sagir567/FinalProject/skull/images/instrucations images/RL.png

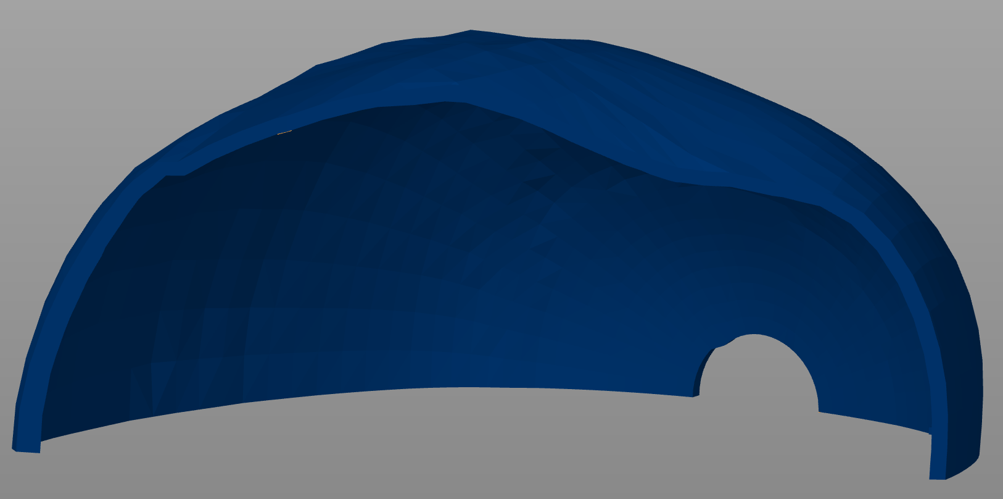
skull/images/instrucations images/RL.png
