sagir567/FinalProject/skull/images/instrucations images/S2.png

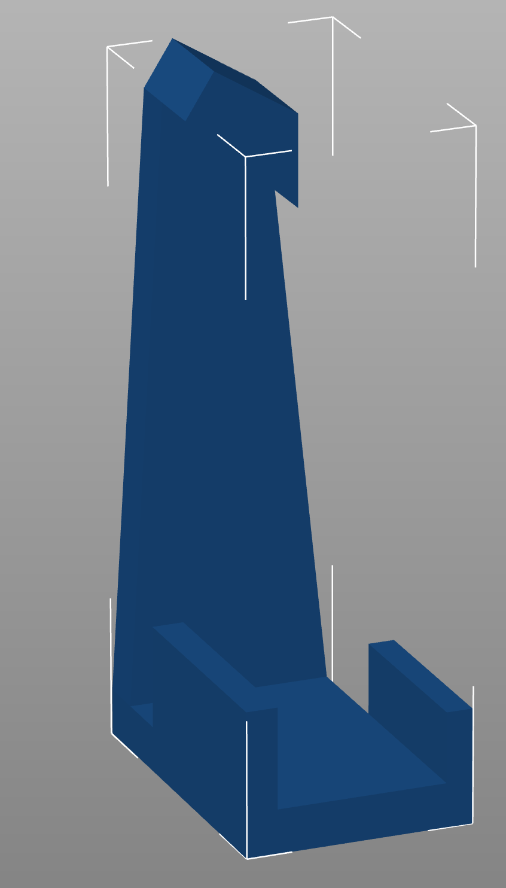
skull/images/instrucations images/S2.png
