sagir567/FinalProject/EMR models/EMR2/Screenshot 2024-11-19 at 12.36.32.png

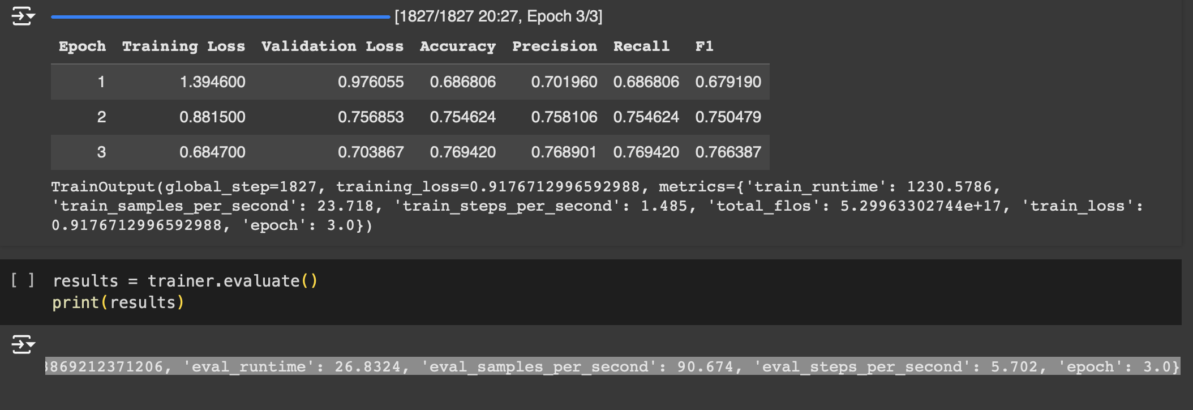
EMR models/EMR2/Screenshot 2024-11-19 at 12.36.32.png
