sagir567/FinalProject/EMR models/EMR3/Screenshot 2024-11-20 at 20.31.09.png

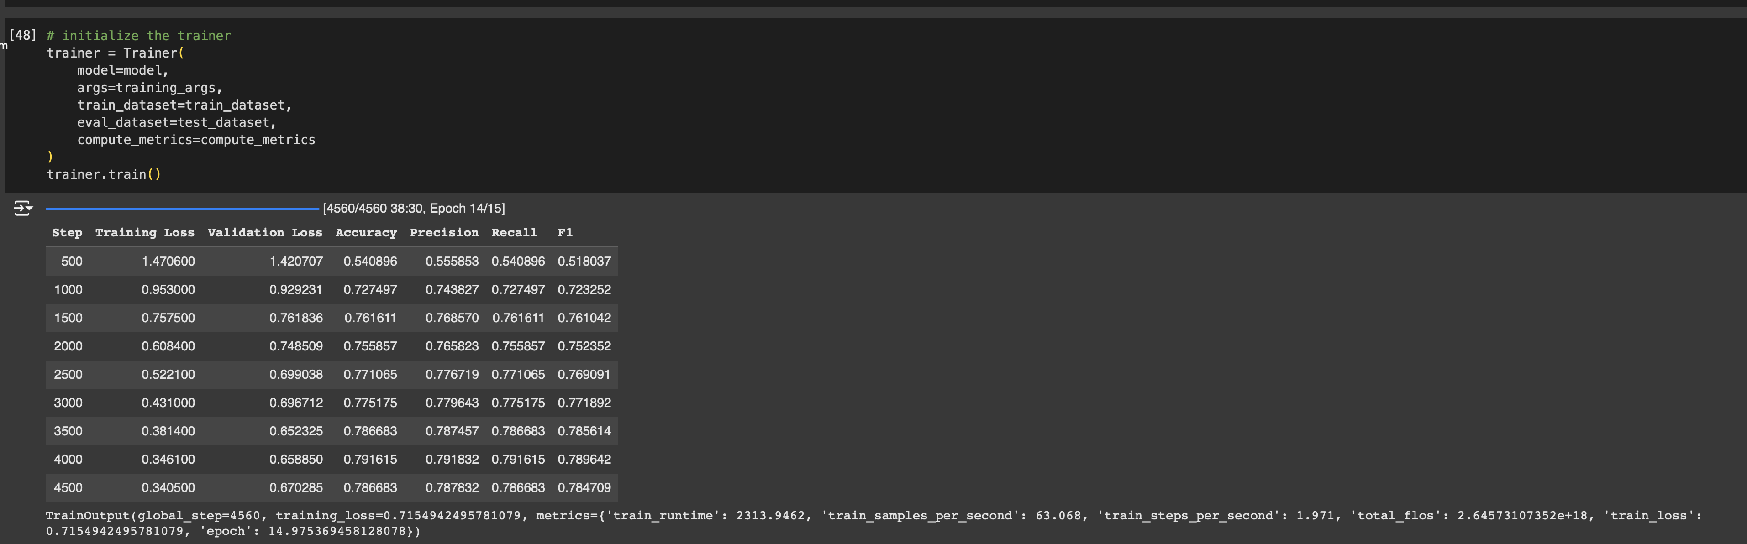
EMR models/EMR3/Screenshot 2024-11-20 at 20.31.09.png
