sagir567/FinalProject/EMR models/EMR4/Screenshot 2024-11-20 at 12.07.46.png

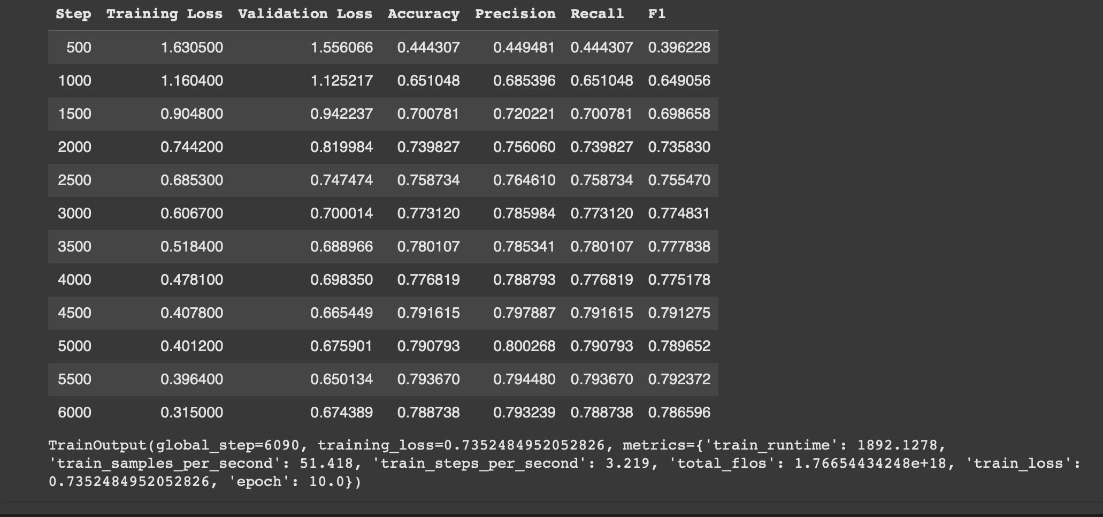
EMR models/EMR4/Screenshot 2024-11-20 at 12.07.46.png
