sagir567/FinalProject/EMR models/EMR4/Screenshot 2024-12-08 at 19.40.34.png

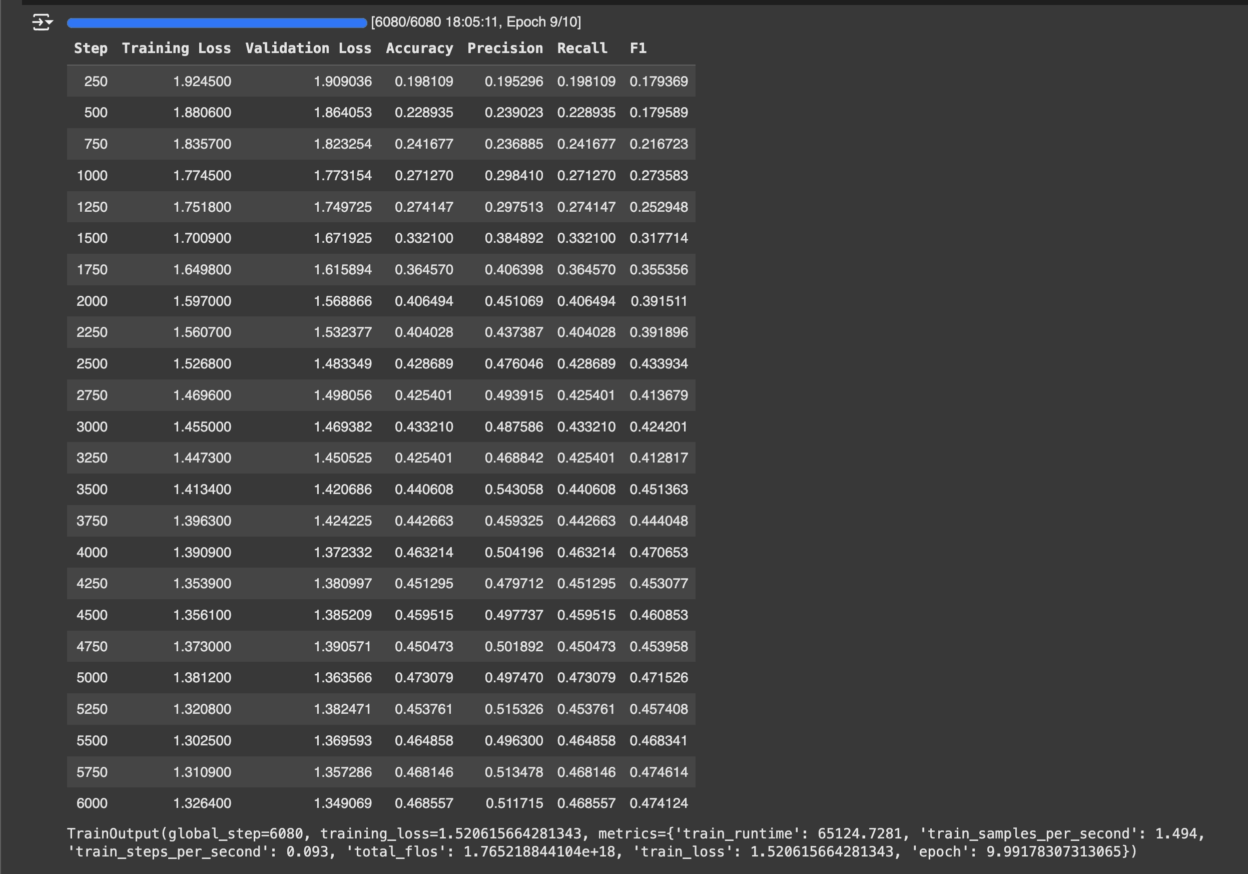
EMR models/EMR4/Screenshot 2024-12-08 at 19.40.34.png
