sagir567/FinalProject/skull/images/4bb4a7c94eef952b9f522b6513d4b394.jpg

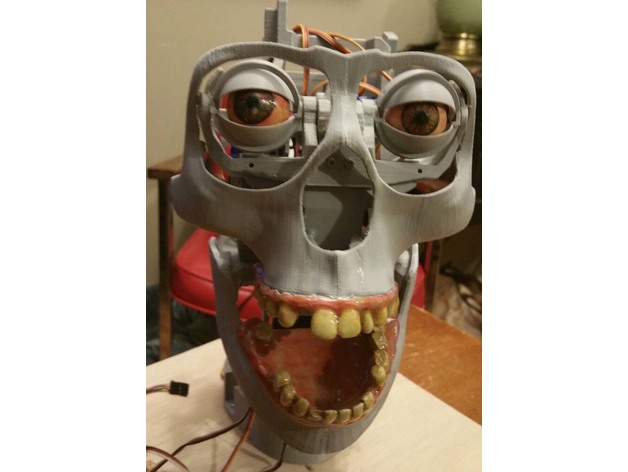
skull/images/4bb4a7c94eef952b9f522b6513d4b394.jpg
