sagir567/FinalProject/skull/images/53bd0c08fc8af762f6f15327d2c29858.jpg

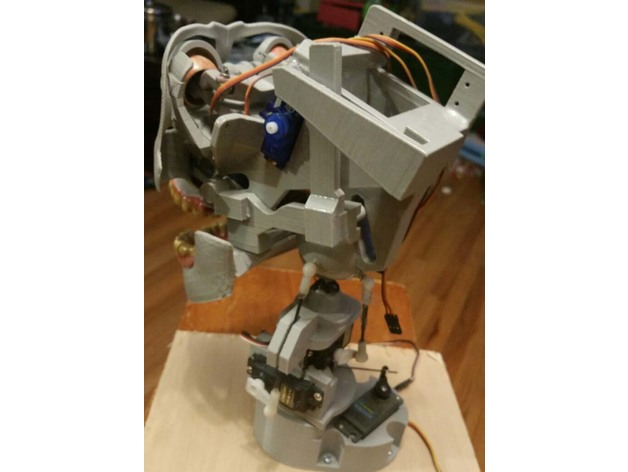
skull/images/53bd0c08fc8af762f6f15327d2c29858.jpg
