sagir567/FinalProject/skull/images/a4908c19597aabf069e994ebf08a3645_display_large.jpg

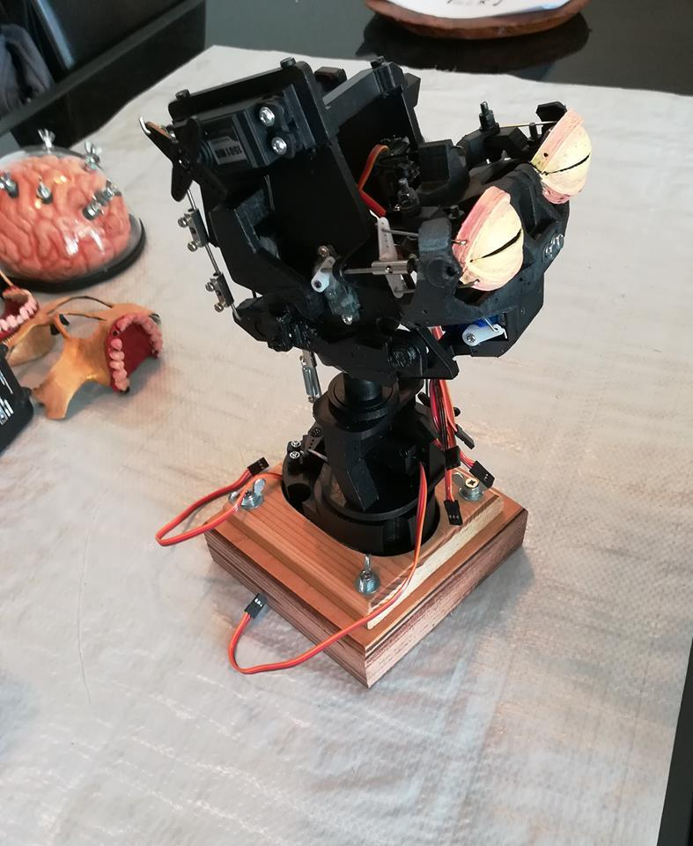
skull/images/a4908c19597aabf069e994ebf08a3645_display_large.jpg
