sagir567/FinalProject/skull/images/base.jpg

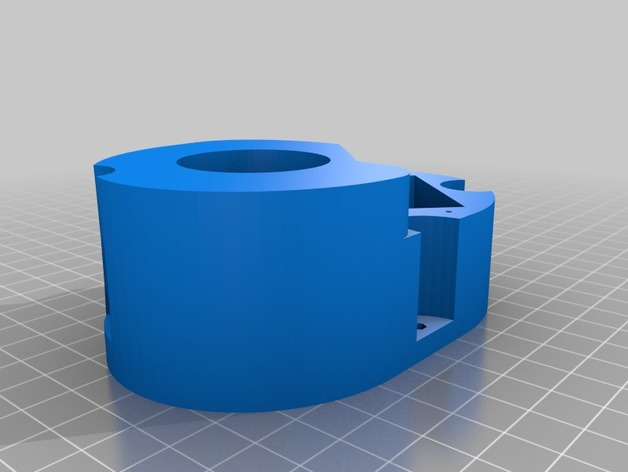
skull/images/base.jpg
