sagir567/FinalProject/skull/images/ccf05b85ca4c89a036585184b309f977.jpg

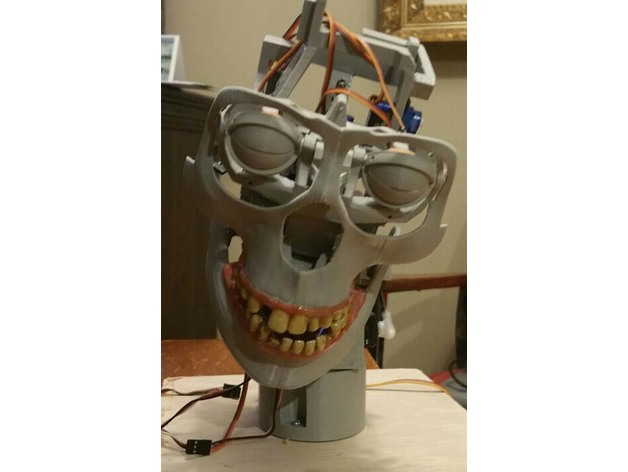
skull/images/ccf05b85ca4c89a036585184b309f977.jpg
