sagir567/FinalProject/skull/images/eyeballs.jpg

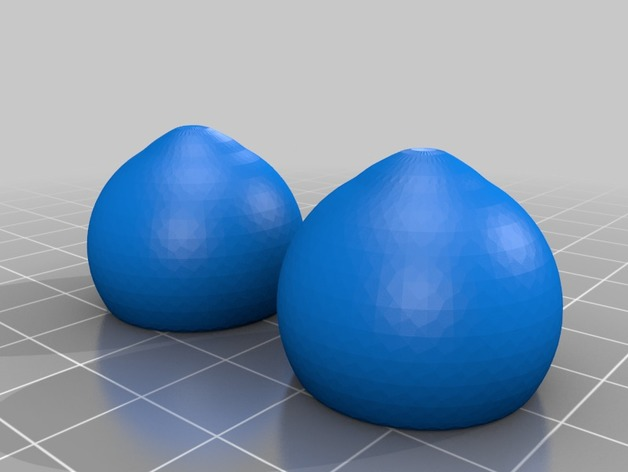
skull/images/eyeballs.jpg
