sagir567/FinalProject/skull/images/eyemech.jpg

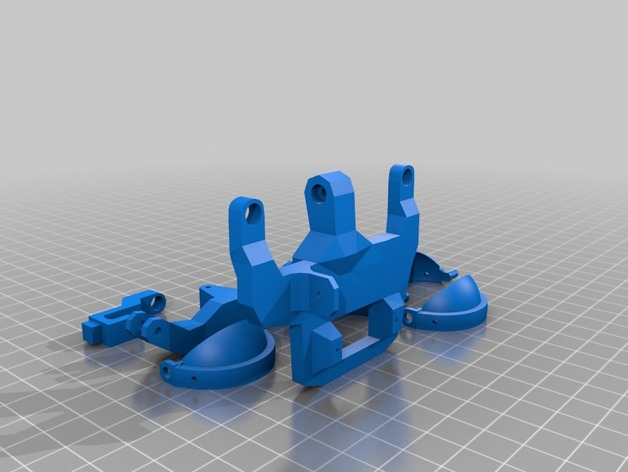
skull/images/eyemech.jpg
