sagir567/FinalProject/skull/images/f3ae5606e1d31408d69cdfd86e3f6843.jpg

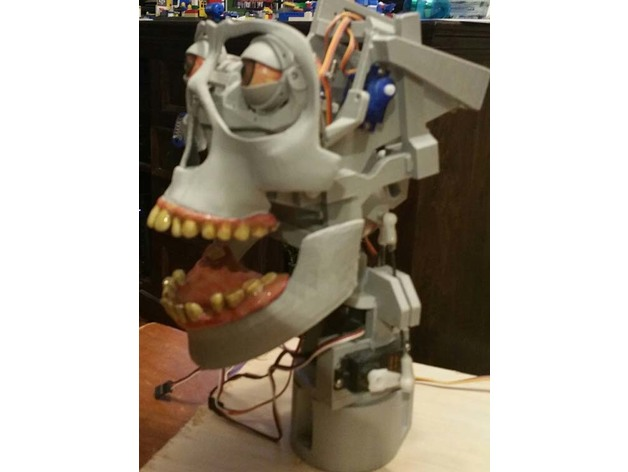
skull/images/f3ae5606e1d31408d69cdfd86e3f6843.jpg
