sagir567/FinalProject/skull/images/face.jpg

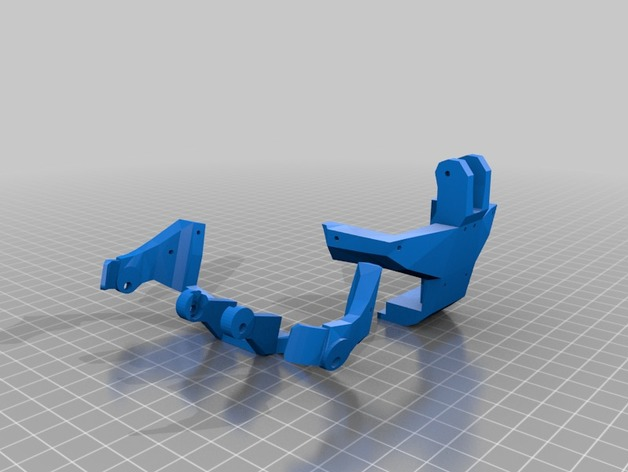
skull/images/face.jpg
