sagir567/FinalProject/skull/images/FullSkull.jpg

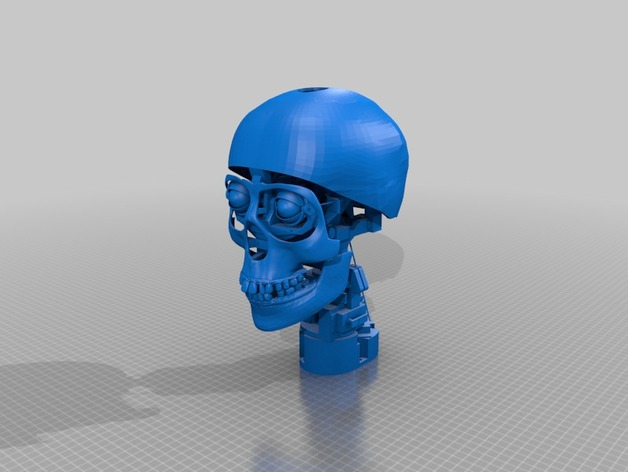
skull/images/FullSkull.jpg
