sagir567/FinalProject/skull/images/J8.png

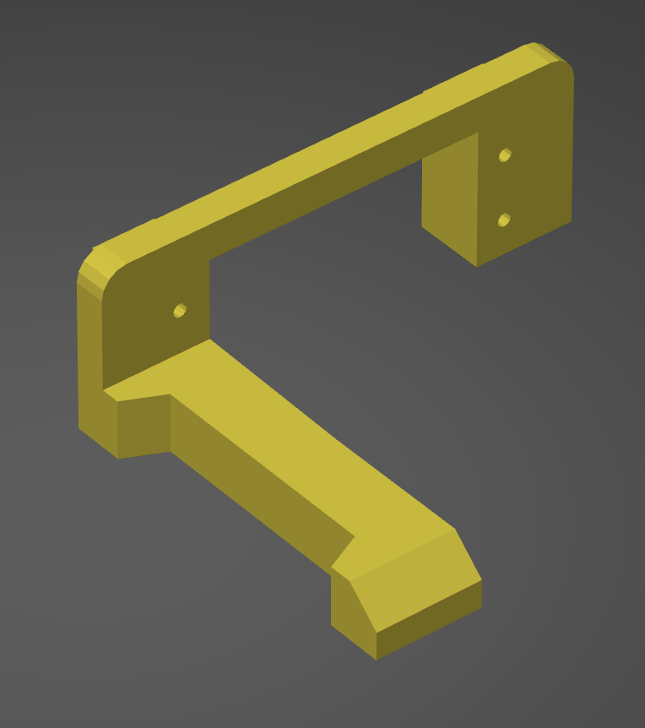
skull/images/J8.png
