sagir567/FinalProject/skull/images/jaw.jpg

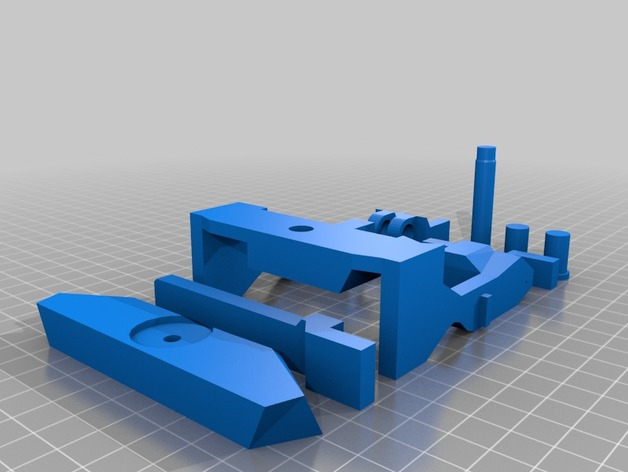
skull/images/jaw.jpg
