sagir567/FinalProject/skull/images/LeftSkull.jpg

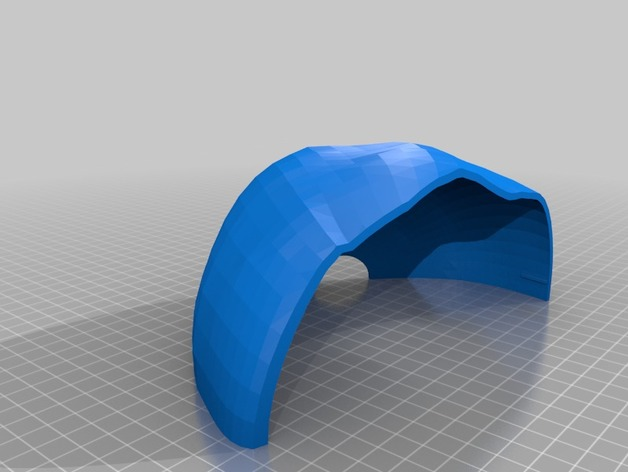
skull/images/LeftSkull.jpg
