sagir567/FinalProject/skull/images/Main.jpg

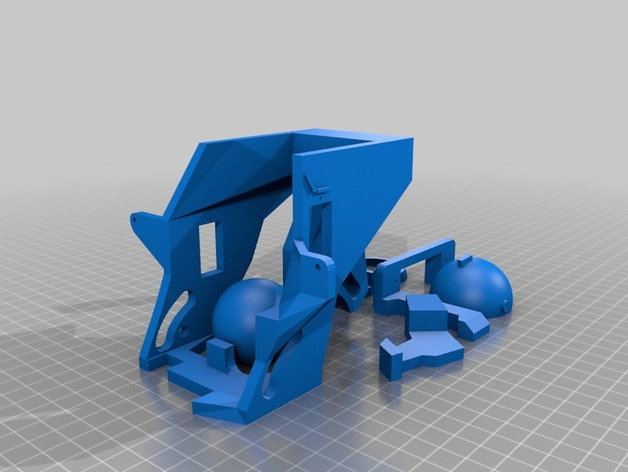
skull/images/Main.jpg
