sagir567/FinalProject/skull/images/Neck.jpg

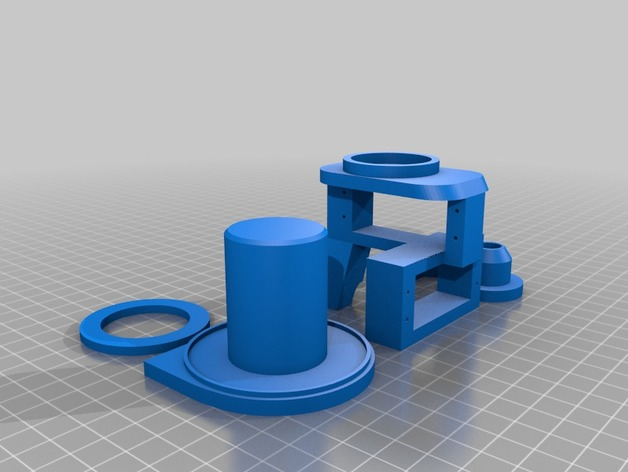
skull/images/Neck.jpg
