sagir567/FinalProject/skull/images/RightSkull.jpg

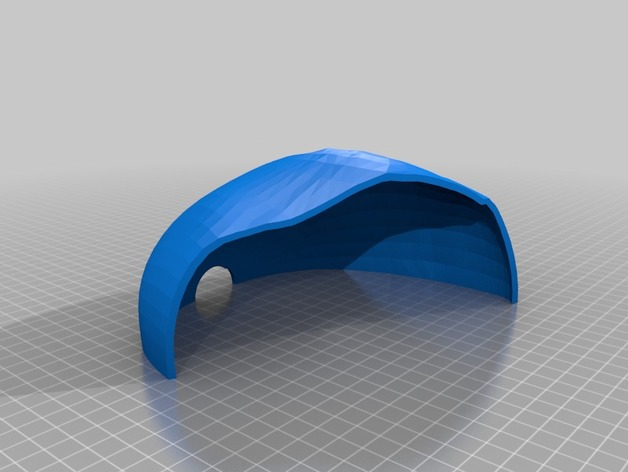
skull/images/RightSkull.jpg
