sagir567/FinalProject/skull/images/skullcapMounts.jpg

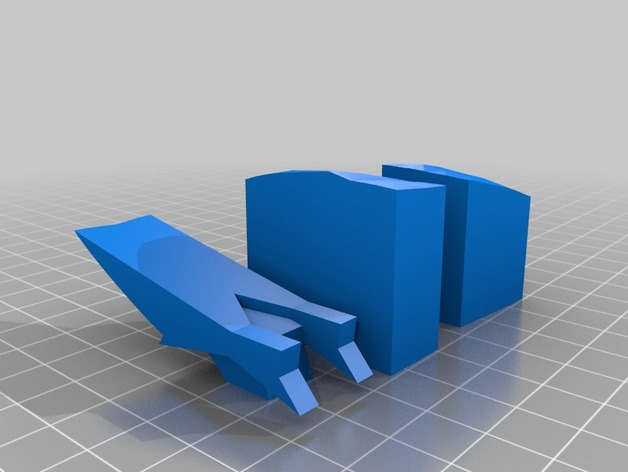
skull/images/skullcapMounts.jpg
