sagir567/FinalProject/skull/images/skullparts.jpg

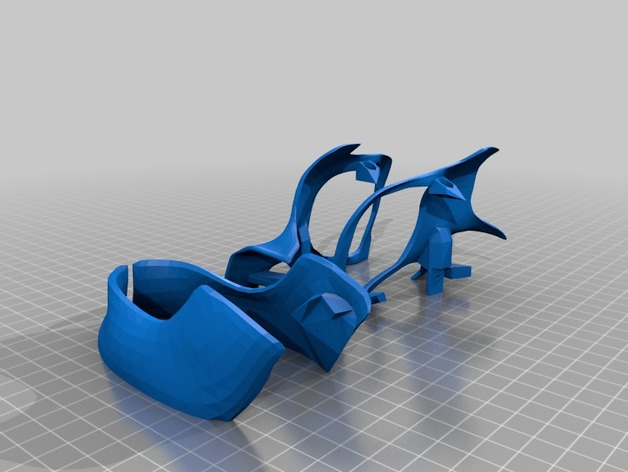
skull/images/skullparts.jpg
