sagir567/FinalProject/skull/images/teeth.jpg

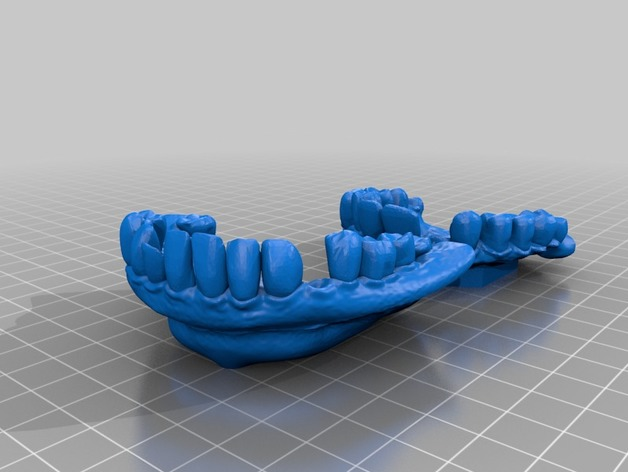
skull/images/teeth.jpg
