sagir567/FinalProject/סכימת פרוייקט.png

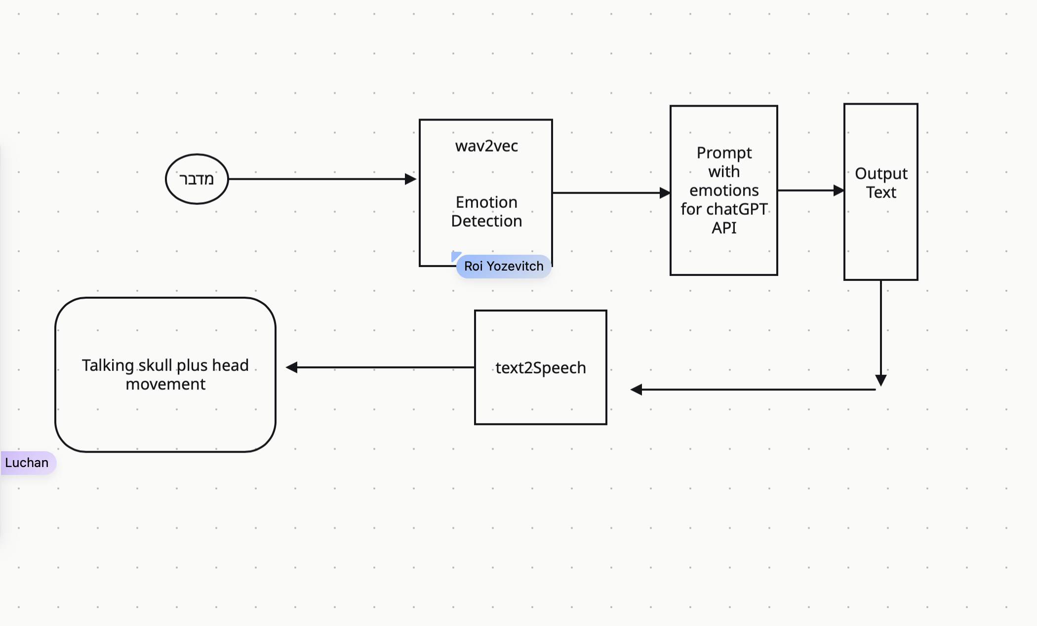
סכימת פרוייקט.png
