sagir567/FinalProject/(list of files, cad)

Other CAD files:
skull/STL/MainBall.stl
skull/STL/FullSkull.stl
skull/STL/Main.stl
skull/STL/MainNoSkelaton.STL
skull/images/instrucations images/B1.stl
skull/STL/neckCup.stl
skull/STL/TopEnclosure.STL
skull/STL/Neck.stl
skull/STL/teeth.stl
skull/STL/eyemech.stl
skull/STL/skullcapMounts.stl
skull/STL/skullparts.stl
skull/STL/eyeballs.stl
skull/STL/RightSkull.stl
skull/STL/jaw.stl
skull/STL/LeftSkull.stl
skull/STL/base.stl
skull/STL/face.stl
skull/STL/Skelaton.STL
skull/STL/microServoWeel.stl
