sagir567/FinalProject/wav2vec2Transformers/Animatronic skull build instructions.docx

Animatronic skull build instructions

Parts:

The projects contains the following parts.

We recommend printing all parts in Brim, 100% scale, 20-30% infill and with Petg(PlA is also an option but you should use higher infill), keep in mind that you don’t want the parts the be too heavy since you’ll need stronger servos.

1*B1: 1*N1: 1*N2:

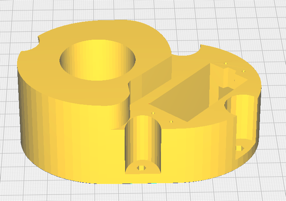
[picture p27: figure]
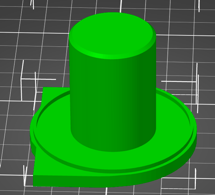
[picture p28: figure]
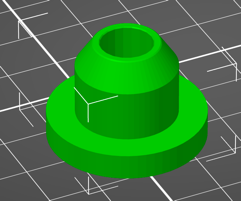
[picture p29: figure]

1*N3: 1*N4: 1*N5:

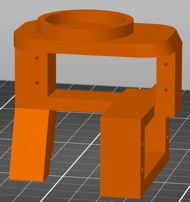
[picture p30: figure]
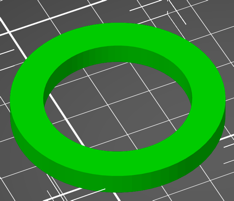
[picture p31: figure]
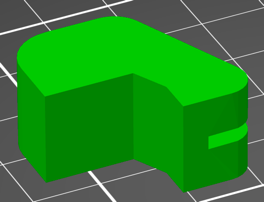
[picture p32: figure]

1*F1: 1*F2: 1*F3:

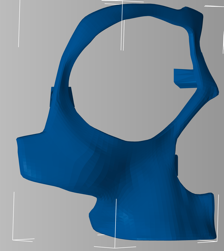
[picture p33: figure]
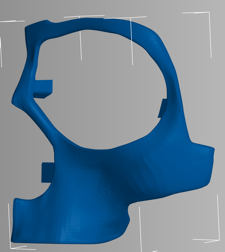
[picture p34: figure]
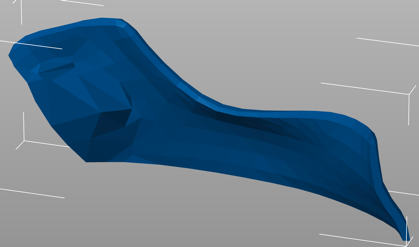
[picture p35: figure]

1*F4: 1*J1:

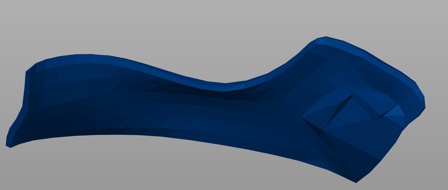
[picture p36: figure]
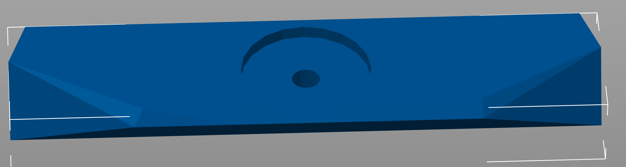
[picture p37: figure]

1*J2: 1*J3:

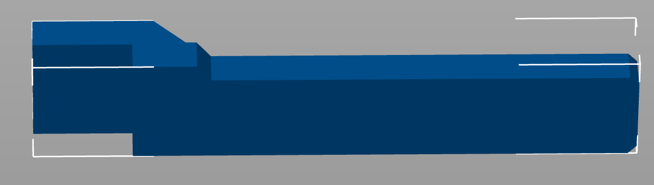
[picture p38: figure]
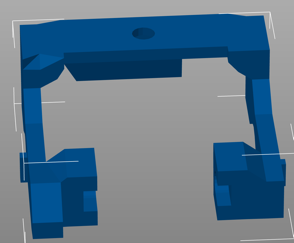
[picture p39: figure]

1*J4: 2*J5: 2*J6:

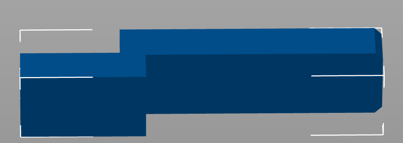
[picture p40: figure]
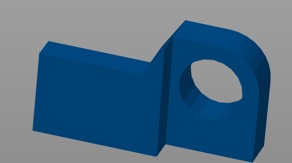
[picture p41: figure]

1*J7: M1: 1*M2:

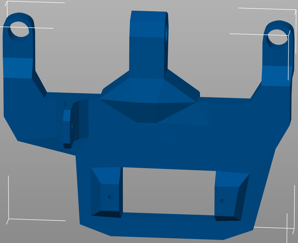
[picture p42: figure]
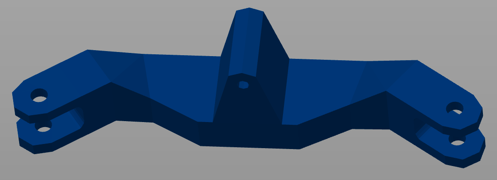
[picture p43: figure]

1*M3: 2*M4:

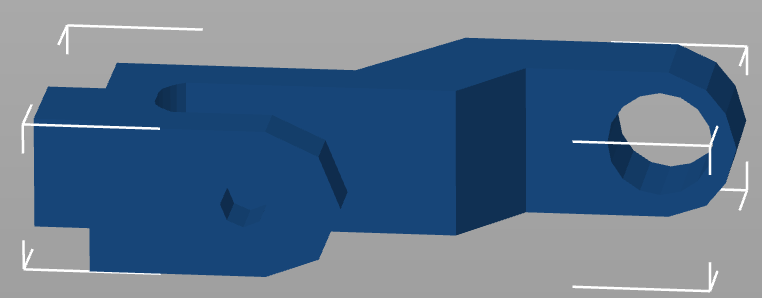
[picture p44: figure]
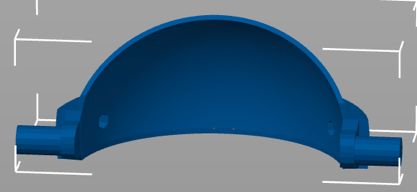
[picture p45: figure]

2*M5: 1*S1: 1*S2:

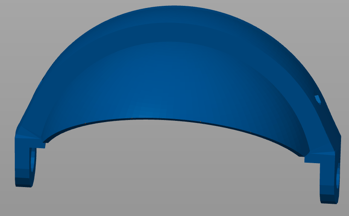
[picture p46: figure]
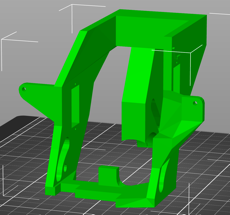
[picture p47: figure]
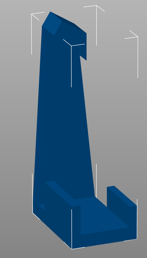
[picture p48: figure]

1*S3: 1*S4:

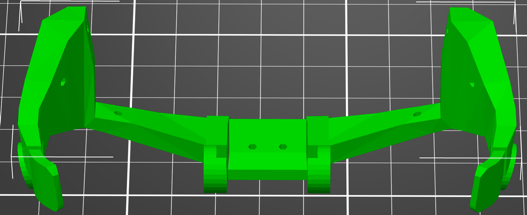
[picture p49: figure]
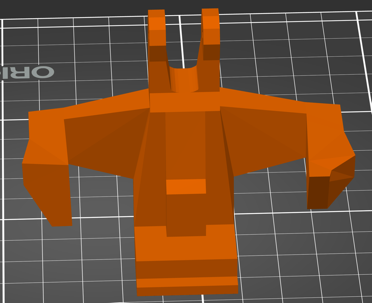
[picture p50: figure]

1*T1: 1*T2:

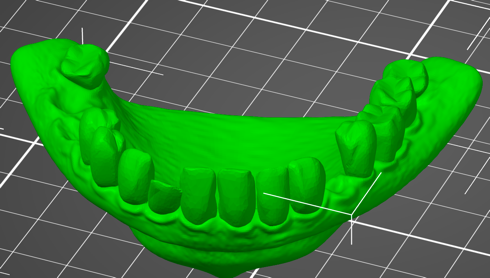
[picture p51: figure]
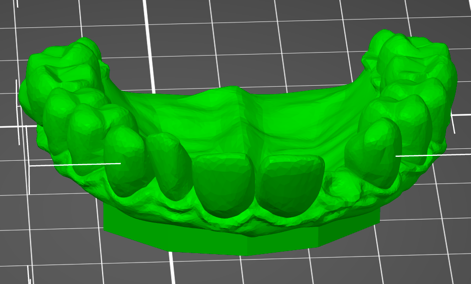
[picture p52: figure]

2*E: 1*RC: 1*RL:

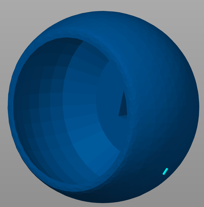
[picture p53: figure]
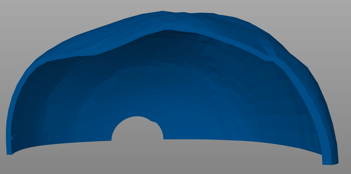
[picture p54: figure]
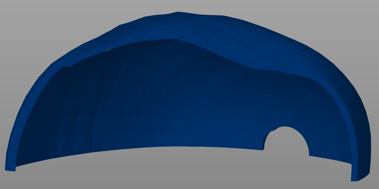
[picture p55: figure]

Tutorial:

1) Connect the M2 to both M3 using two m3 screws connector ( you may use hot glue to position the screw connector inside the M2 so there will be minimum loose)

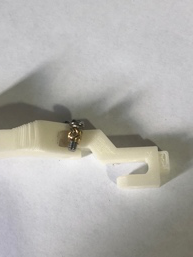
[picture p56: figure]
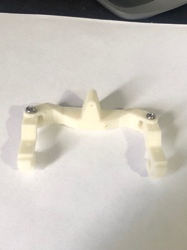
[picture p57: figure]
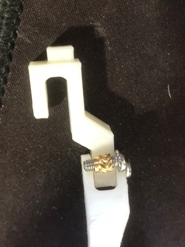
[picture p58: figure]

2) Connect M2 and M3 to the M1 using the same screw connector,
- the hook on the M1 supposed to be directed down.
- Use the same screw connector and two m3 screws

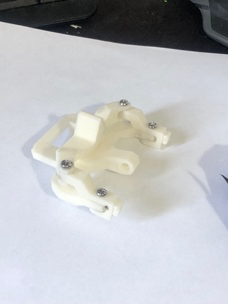
[picture p59: figure]
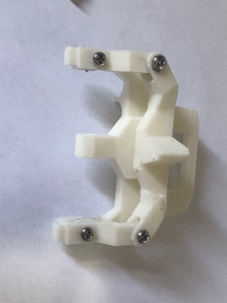
[picture p60: figure]
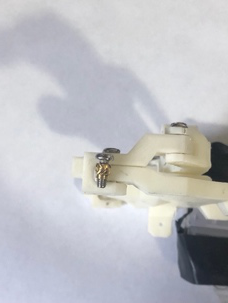
[picture p61: figure]

3) Using two m3 screws and 2 screws connectors connect M1 to S4, screws head should be in the outer side of S4

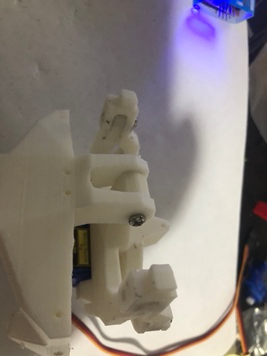
[picture p62: figure]
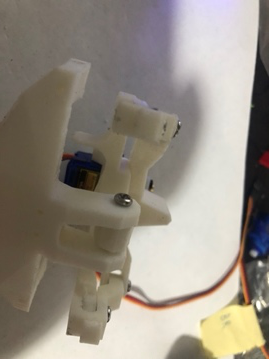
[picture p63: figure]
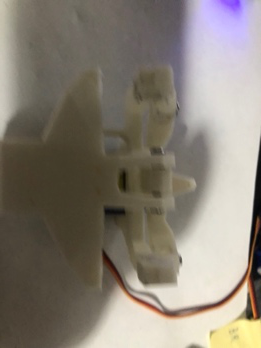
[picture p64: figure]

…………………….

4) Connect one mini servo to the M1, servo hand should be assemble from the left size, plug one pushed stoper to the servo and connect one hook to it , the hook should be inserted into the small hole in the M1 part

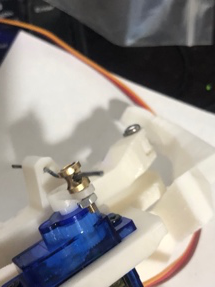
[picture p65: figure]
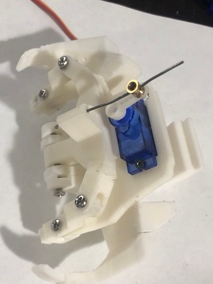
[picture p66: figure]
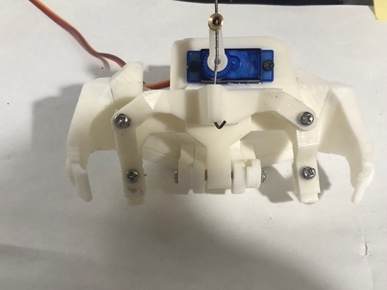
[picture p67: figure]
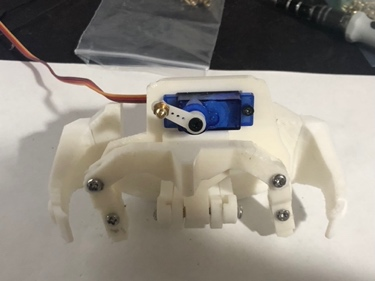
[picture p68: figure]

5) Take both J6 parts and glue them to the side of J3, after that plug both J5 parts to the H6 hole
- Flat part of J6 should be directed down.
- Before glue J6 parts make sure they move a bit loose in the S1 rials, if they don’t move loose, gently sand the S1 rails.

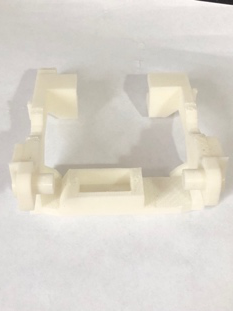
[picture p69: figure]
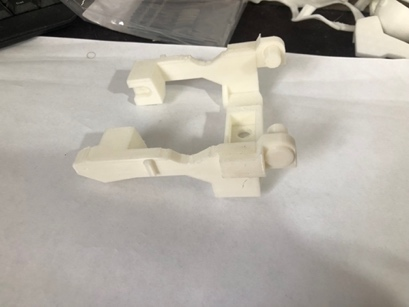
[picture p70: figure]
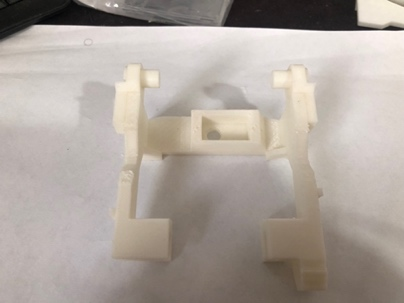
[picture p71: figure]

6) Screw one mini servo to the J3.
- The servo should be metal and a bit stronger because it need to lift and move the jaw part of the skull.

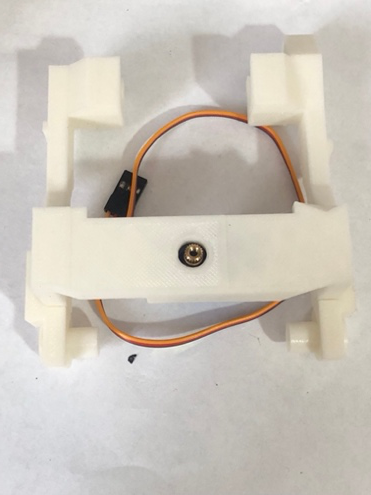
[picture p72: figure]
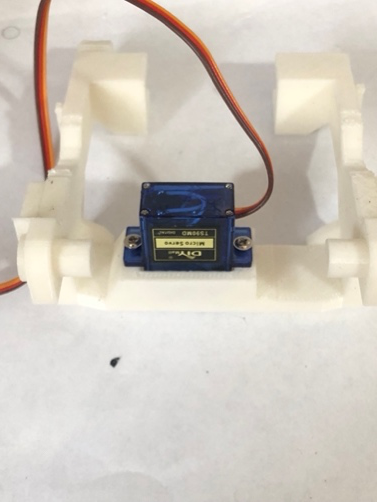
[picture p73: figure]
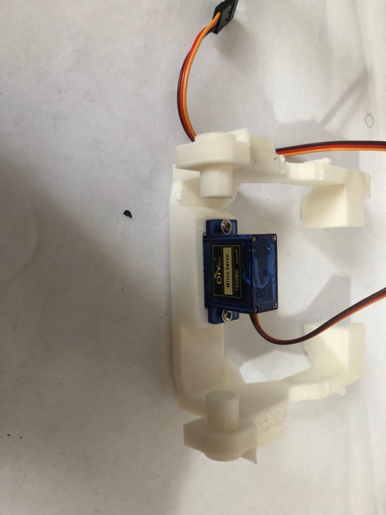
[picture p74: figure]

7) Take F3 and F4 and glue them together to T2
- Make sure you leave enough place between F3 and F4 to place J1

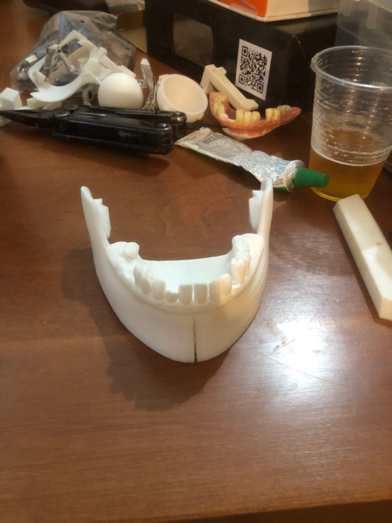
[picture p75: figure]
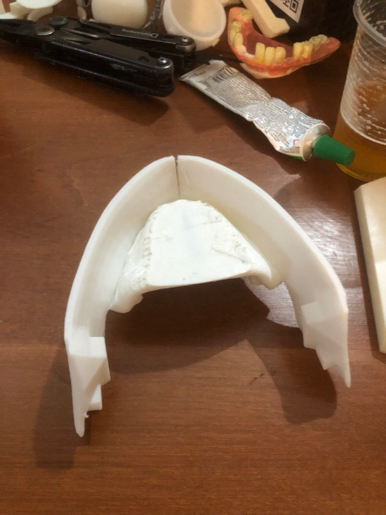
[picture p76: figure]

8) After the last part dry, connect glue J1 between F3 and F4,
- Servo wheel adapter should be position up direction, while its open side should be pointed opposite direction then the teeth

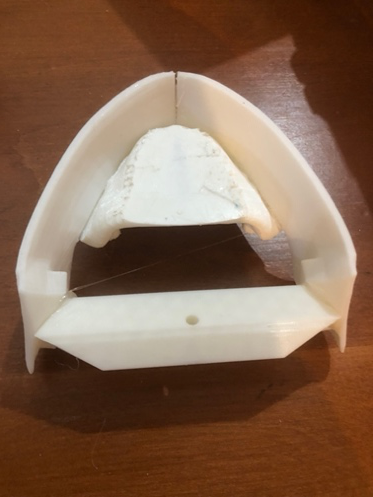
[picture p77: figure]
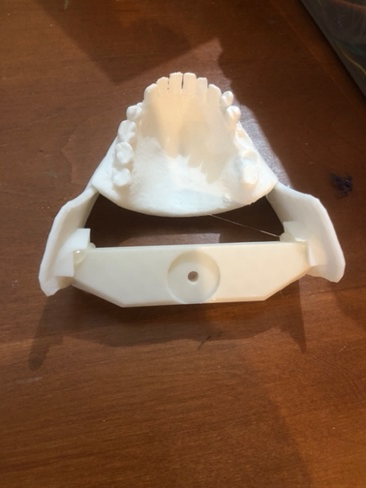
[picture p78: figure]

9) Use two m2 screws to connect F1 to the eye mech to build in the previous episodes, follow the same with F2

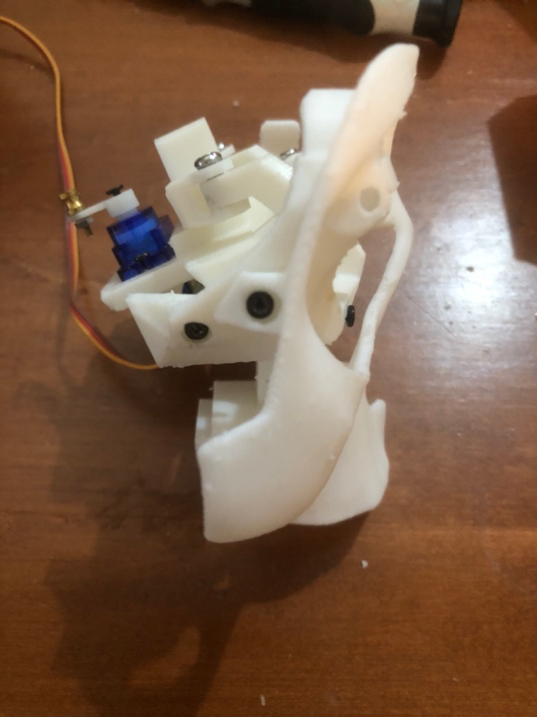
[picture p79: figure]
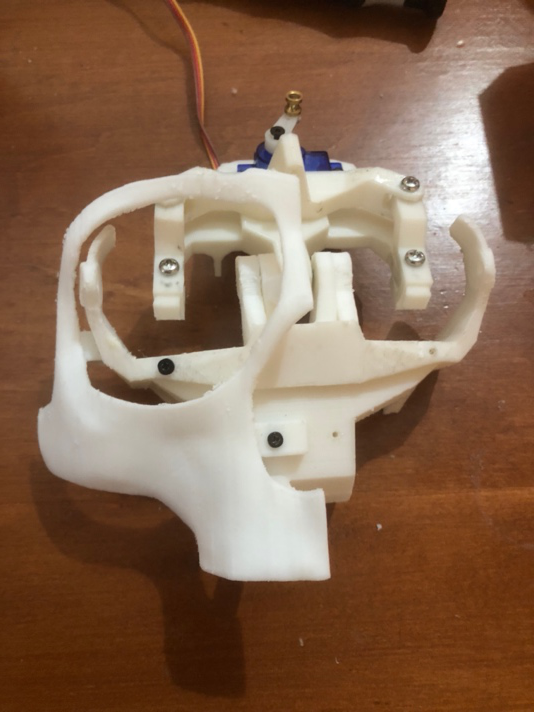
[picture p80: figure]

10) After co nnecting F1 and F2 to the face, glue T2 to it.

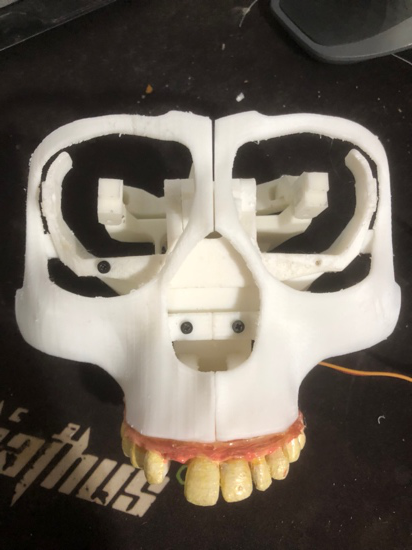
[picture p81: figure]
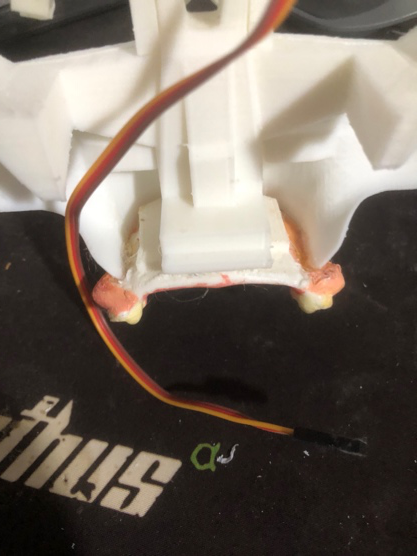
[picture p82: figure]
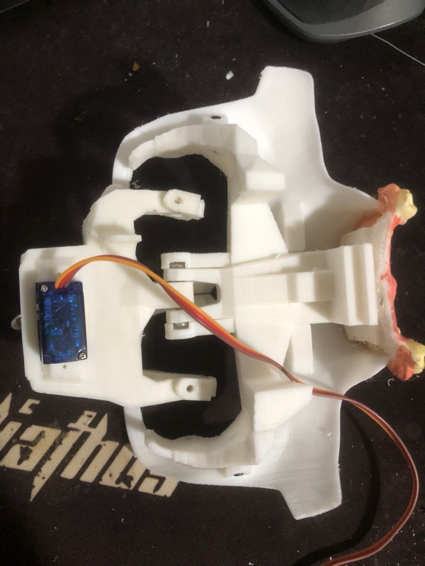
[picture p83: figure]

11) Use one hook connector to connect the xEyesServo to M2 part,
- check for smote movement
- check for the servo min max and base degrees
- save them as XeyesMin, XeyesMax, xEyesBase for future instructions

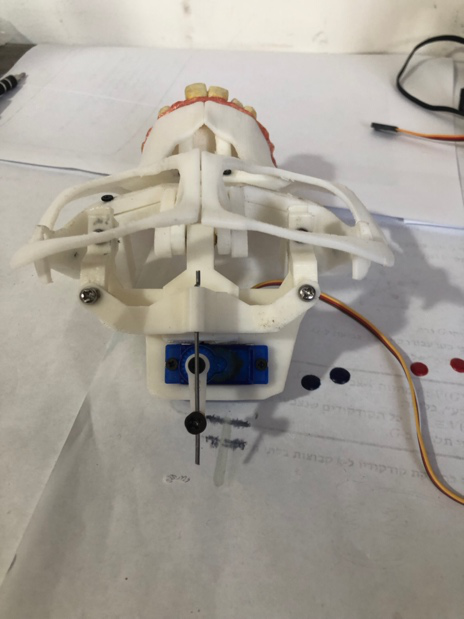
[picture p84: figure]
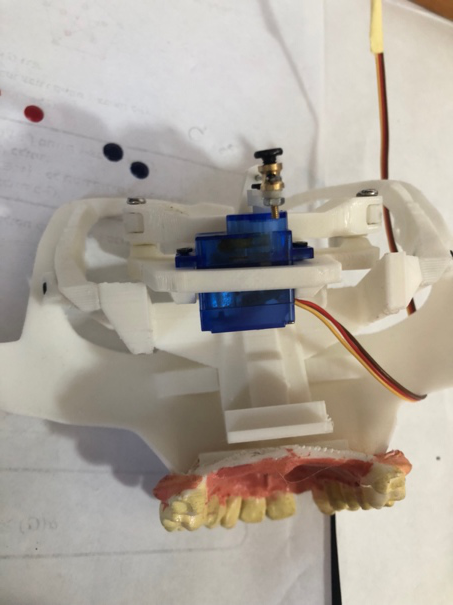
[picture p85: figure]

12) Take the assembled J3 from stage 6 and connect it to S1 carefully using J7
- Before glue the parts make sure you got a full and easy movement, otherwise the servo will not be able to move it smoothly, if needed polish S1 to getter a smoother movement.

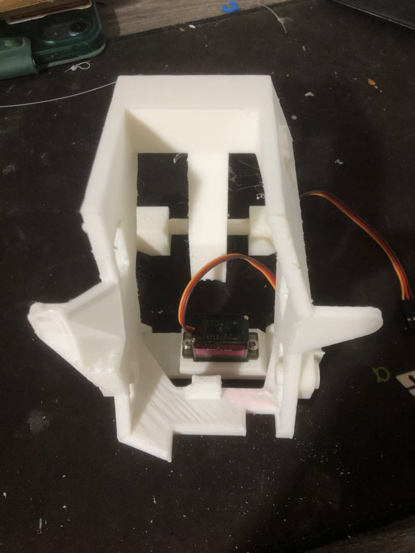
[picture p86: figure]
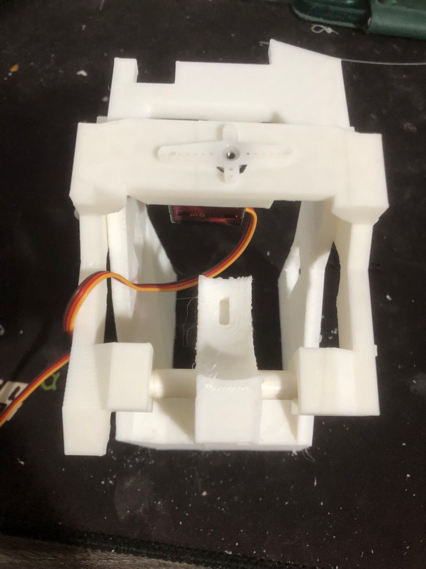
[picture p87: figure]
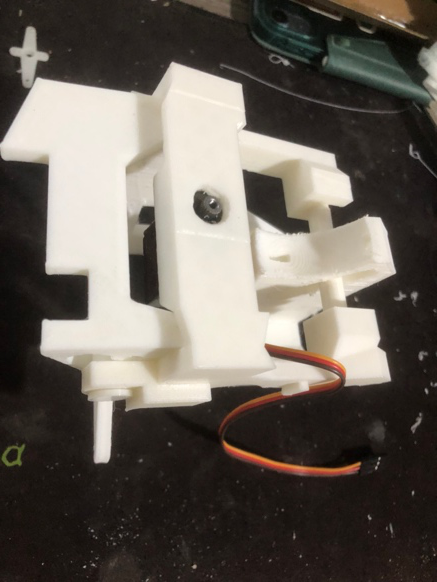
[picture p88: figure]

13) Connect two servos to the sides of S1.
- servos should be direction up

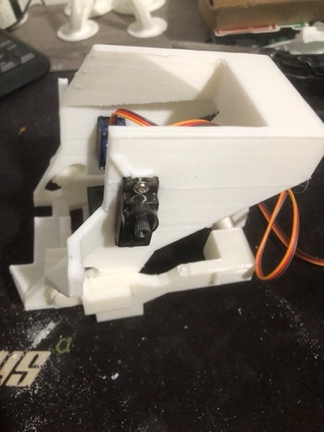
[picture p89: figure]
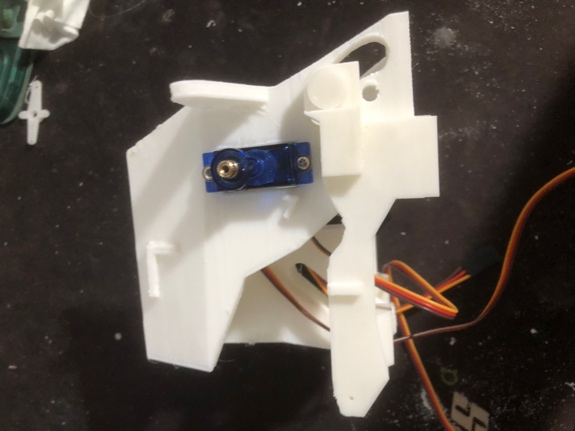
[picture p90: figure]
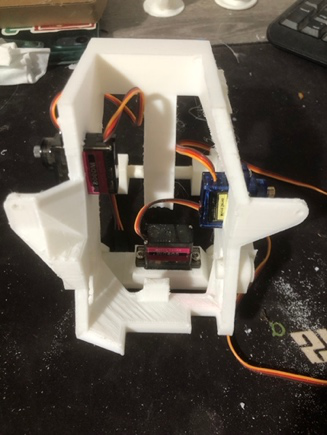
[picture p91: figure]

14) Take S1 and connect it to J1 using 1 mini servo
- This is the one of the important part in the assembly,
- drill one servo hand or weel to J1 , the screw hight should not be higher then the J1 circle hole other wise the jaw will not be closed smoothly on the final assembly
- use strong servo and connet it with a screw from the hole at J1 directly to the servo hole in S1.
- You better make sure evrything is works good now instead of taking all apart later
- After done it right check the servos min max and base degree as JawMin ,JawMax ,JawBase for future instuctions .

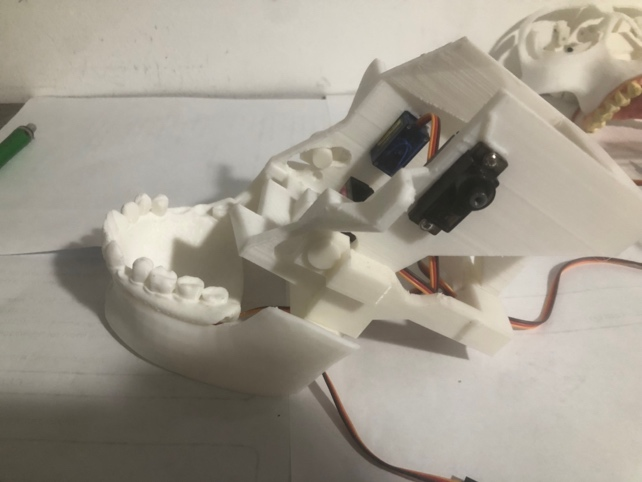
[picture p92: figure]
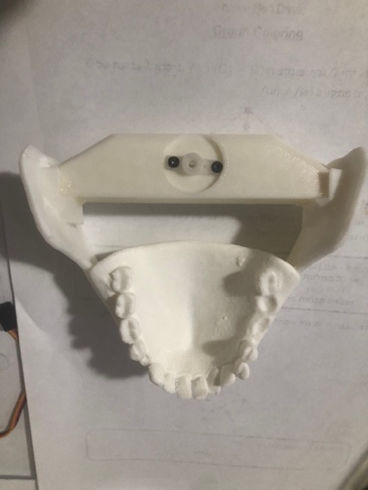
[picture p93: figure]
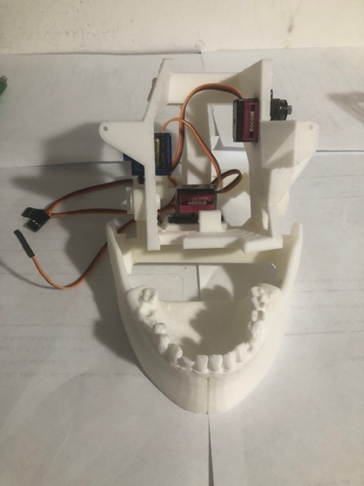
[picture p94: figure]

15) Sling N1 into B1 hole, check for smooth movement , j1 should be place under B1

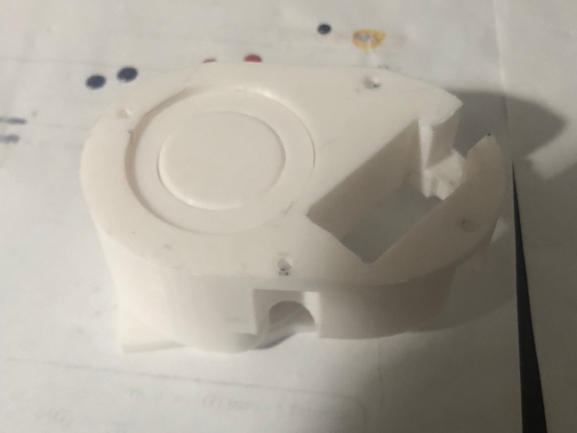
[picture p95: figure]
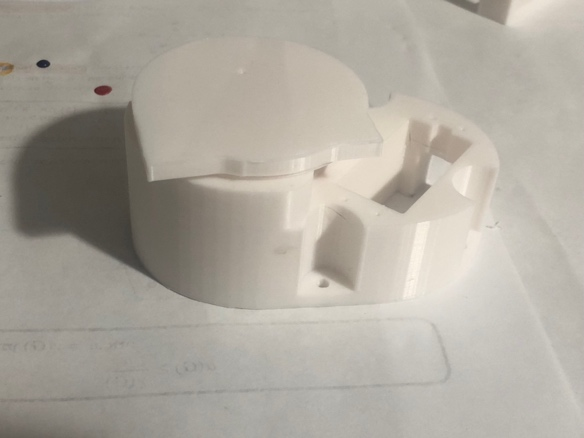
[picture p96: figure]

16) Connect with a hook one servo from B1 to N1
- You should use hook connector on servo and on the N1
- Check for servo movement before continue, after the next step recalibrate the servo position will be hard and you will have to unglue the parts
- After screwing the servo check is min and max angle and save them aside for future instructions

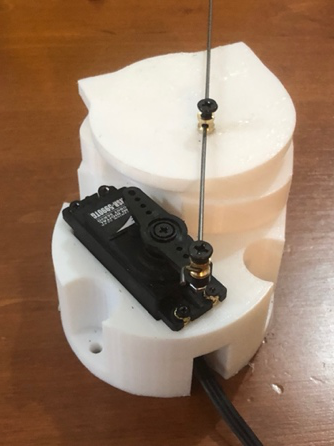
[picture p97: figure]
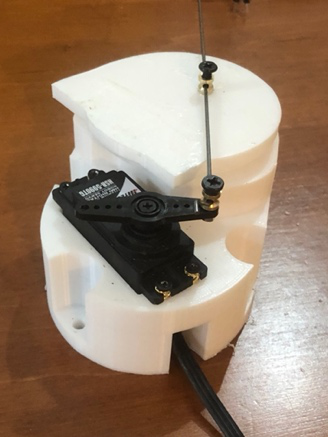
[picture p98: figure]
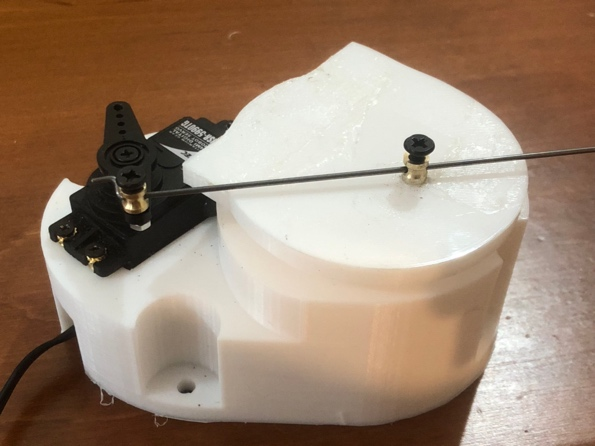
[picture p99: figure]

17) Glue N1 to N3
- Bottom servo should be lined with N1 flat size

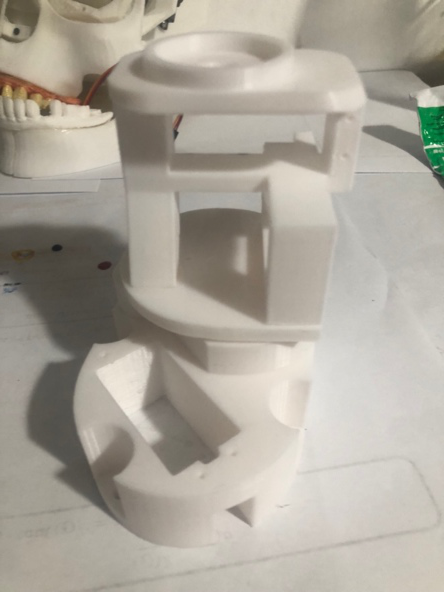
[picture p100: figure]
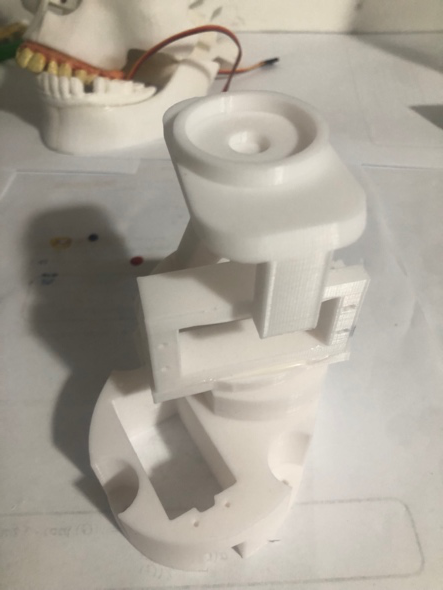
[picture p101: figure]

18) Glue N2 to N3
- Make sure the glue dosent leaked to the hole other wise it will make you hard time to connect the skull head to the neck

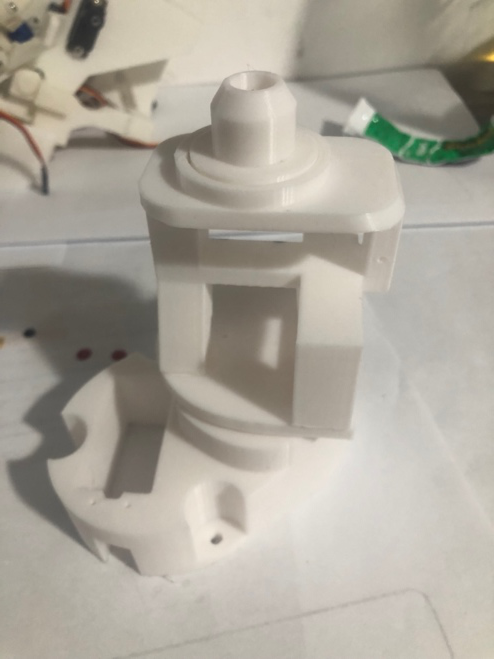
[picture p102: figure]
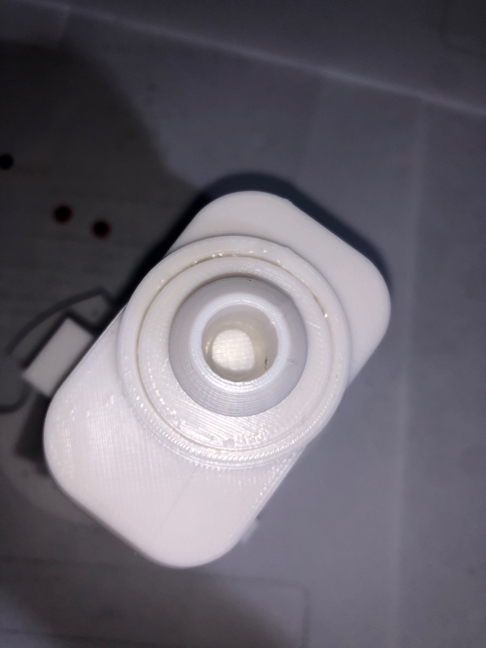
[picture p103: figure]

19) Glue N5 to the side of N3

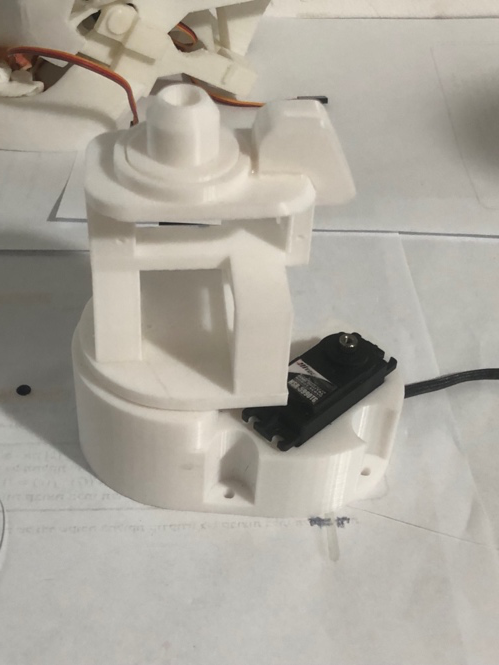
[picture p104: figure]
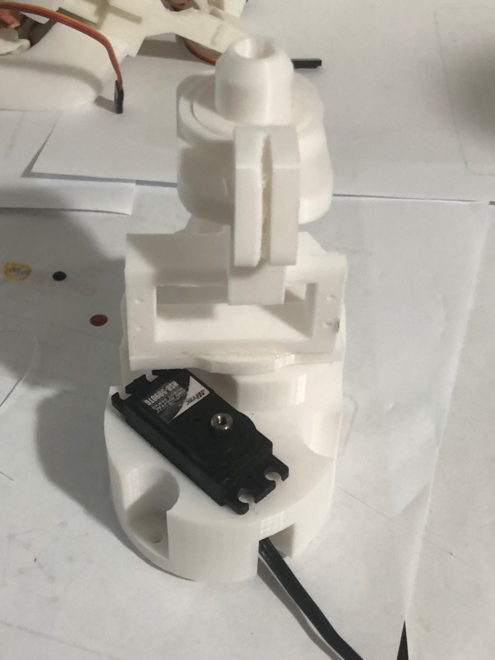
[picture p105: figure]
