sagir567/FinalProject/skull/images/instrucations images/B1.png

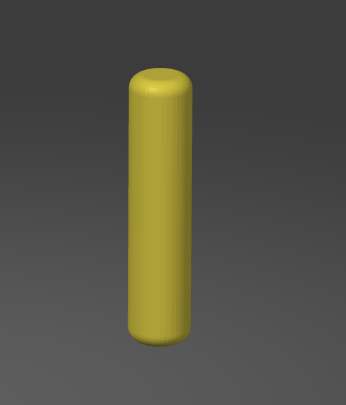
skull/images/instrucations images/B1.png
