sagir567/FinalProject/skull/images/instrucations images/B2.png

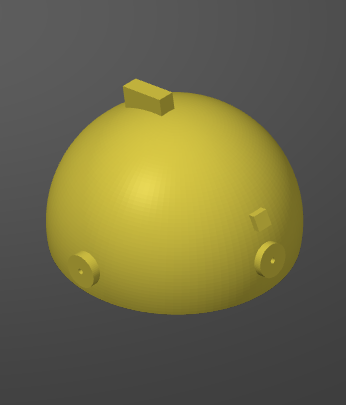
skull/images/instrucations images/B2.png
