sagir567/FinalProject/skull/images/instrucations images/B3.png

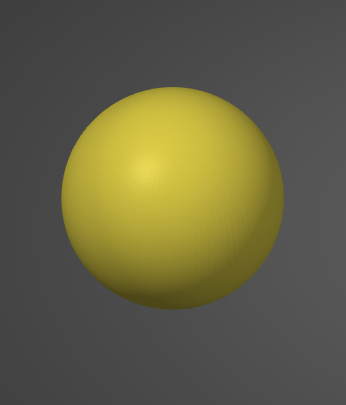
skull/images/instrucations images/B3.png
