sagir567/FinalProject/skull/images/instrucations images/F1.png

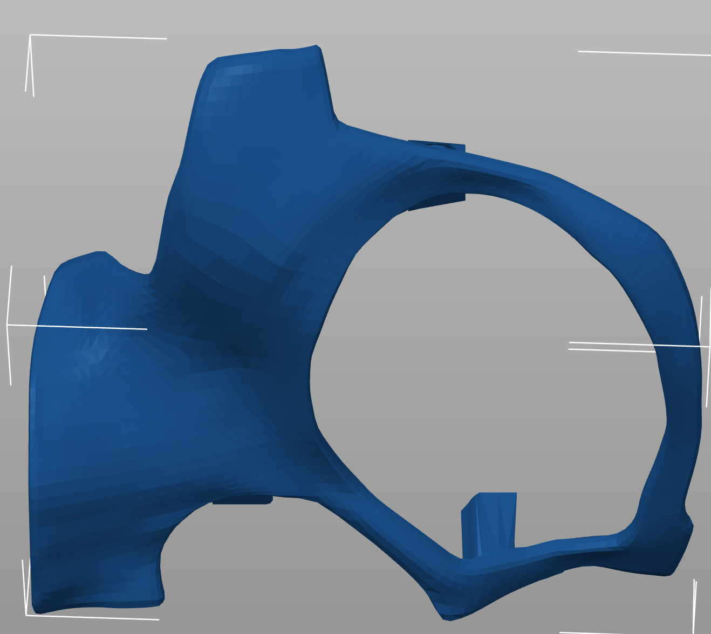
skull/images/instrucations images/F1.png
