sagir567/FinalProject/skull/images/instrucations images/F2.png

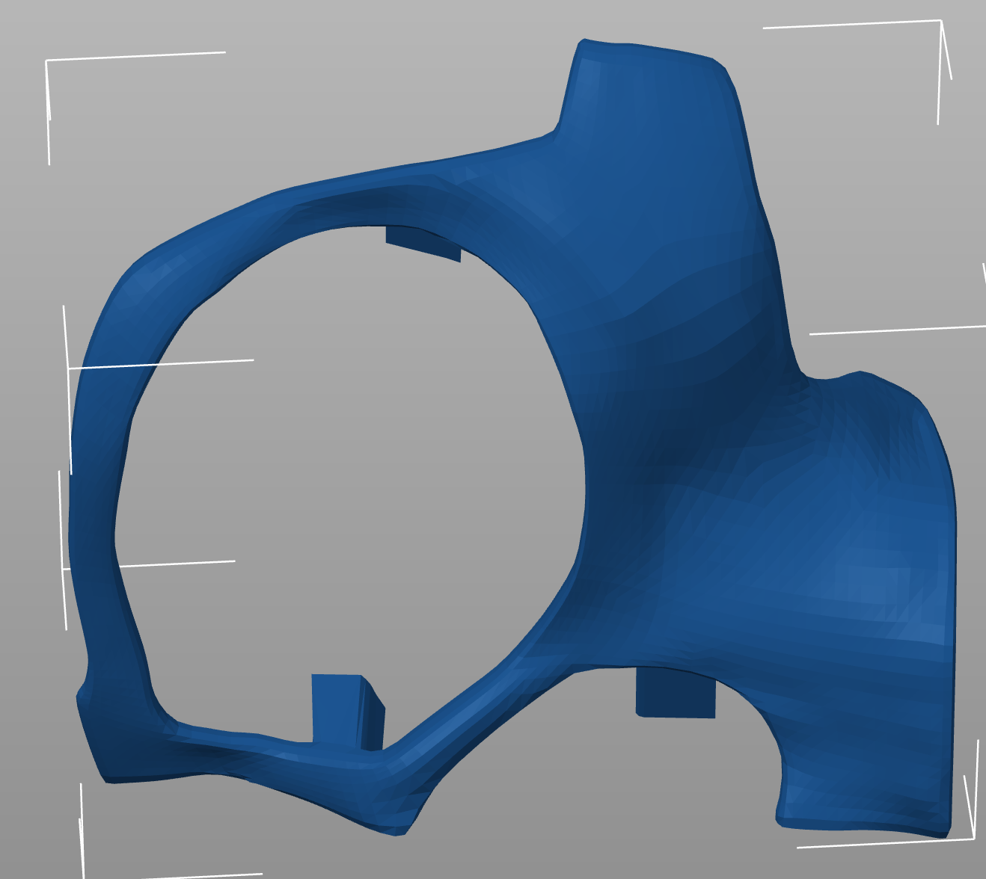
skull/images/instrucations images/F2.png
