sagir567/FinalProject/skull/images/instrucations images/J5.png

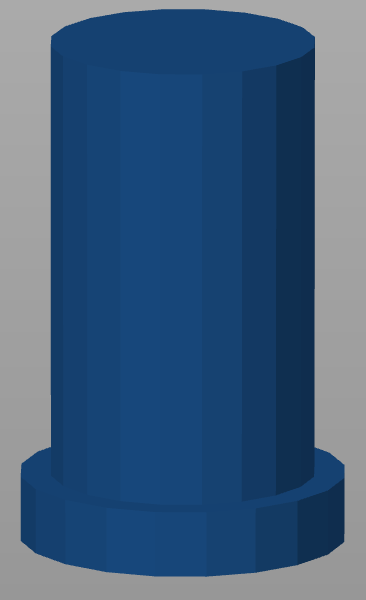
skull/images/instrucations images/J5.png
