sagir567/FinalProject/skull/images/instrucations images/J7.png

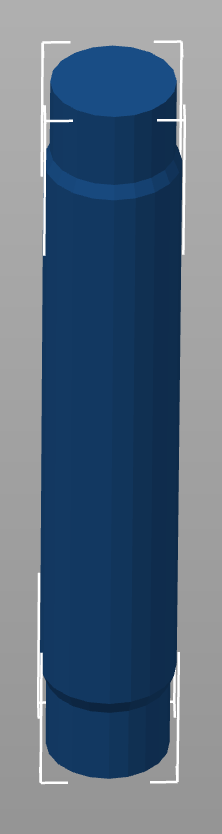
skull/images/instrucations images/J7.png
