sagir567/FinalProject/skull/images/instrucations images/J9.png

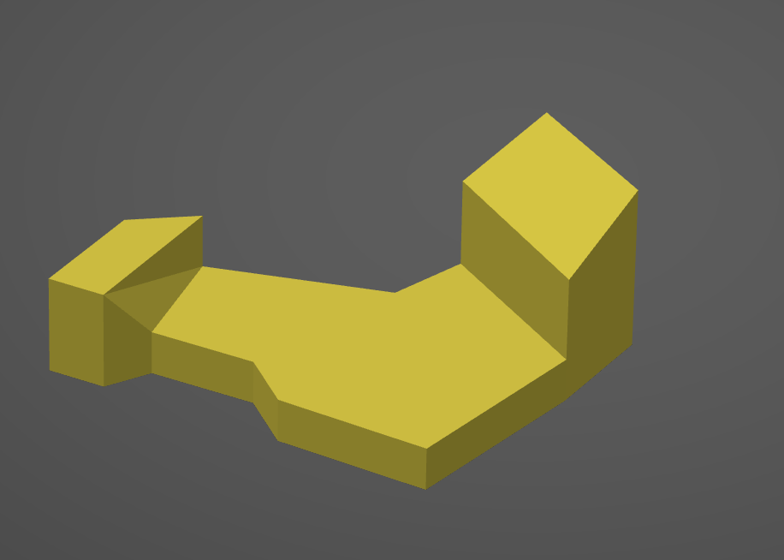
skull/images/instrucations images/J9.png
