sagir567/FinalProject/(commit log)

2024-03-28 init repo
    [Bottom Left Lid.stl, Bottom Lid Link (x2).stl, Bottom Right Lid.stl, Eye Adaptor (x2).stl, Eye Holder.stl, Fork (x2).stl, LeftSkull.stl, Main Base.stl]
2024-04-06 new plannig and mid year summery
    [Bottom Left Lid.stl, Bottom Lid Link (x2).stl, Bottom Right Lid.stl, Eye Adaptor (x2).stl, Eye Holder.stl, Fork (x2).stl, LeftSkull.stl, Main Base.stl]
2024-05-01 new notebook
    [microServoWeel.stl]
2024-05-26 new lstm model for emotion recognition
    [Sum_df.csv]
2024-09-15 new papers and assembly tutorial
    [FullSkull.stl, LeftSkull.stl, Main.stl, MainNoSkelaton.STL, Neck.stl, RightSkull.stl, Skelaton.STL, TopEnclosure.STL]
2025-01-04 arduino control for skull2 done
    [B1.stl, MainBall.stl, microServoWeel.stl, neckCup.stl]
